jdc-cunningham/esp01-hydration-sensor/arduino/README.md

### About
The seeeduino interfaces with the moisture sensor and then uses the ESP-01 for WiFi communication to a local web server through HTTP.
