jdc-cunningham/esp01-hydration-sensor/arduino/esp_01/README.md

### About
This approach "failed".

Specifically I could not step the voltage down from the 3V max output of the analog sensor output for the ESP to consume it through the 1V max ADC.

This is one of the configurations I tried(other didn't have the MOSFET)

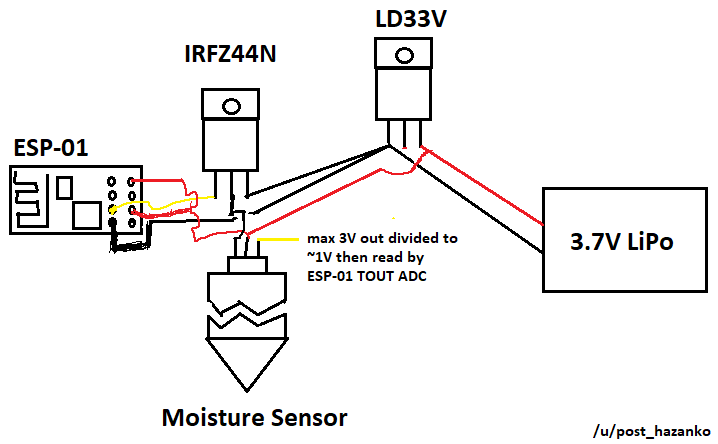
[picture p1: arduino/esp_01/wiring-diagram.png]
with mosfet


The on/off aspec works great, but as mentioned anytime I tried to drop the voltage down it would make the sensor not work.

Normally the sensor outputs between 2.2-2.6V in air and drops to 1.2V or so "fully submerged" in a cup of water.

That stops happening once I try to mod the output voltage.

I don't have any other components/parts at the moment to drop that voltage down and have spent far too much time on this version.

I just want "a moisture sensor" and I have these other ESP's to work with now.

I want to finish this project and move on.

The other version without MOSFET

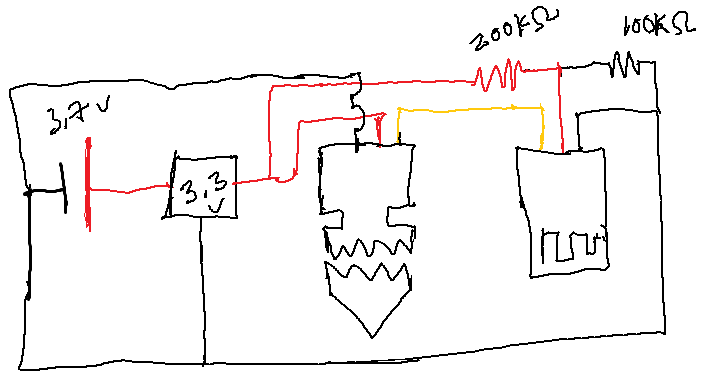
[picture p2: arduino/esp_01/circuit-diagram.png]
no MOSFET


Here it is wired up, I pulled off the yellow/black wires for probing, trying to get the analog value stepped down. The 330 ohm total resistance was too low also, had to use Mega Ohms to get near 1V vs. 0.008V

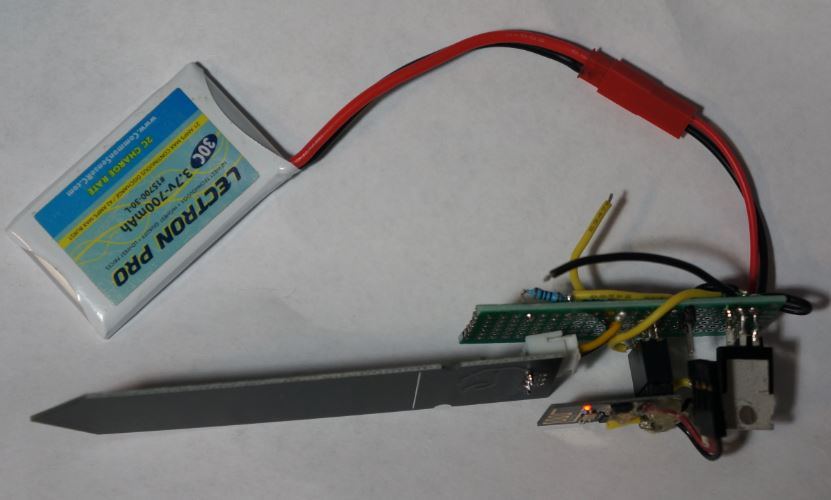
[picture p3: arduino/esp_01/esp-01-last-state.JPG]
last wired up state
