jdc-cunningham/esp01-hydration-sensor/3d-files/test-print.stl

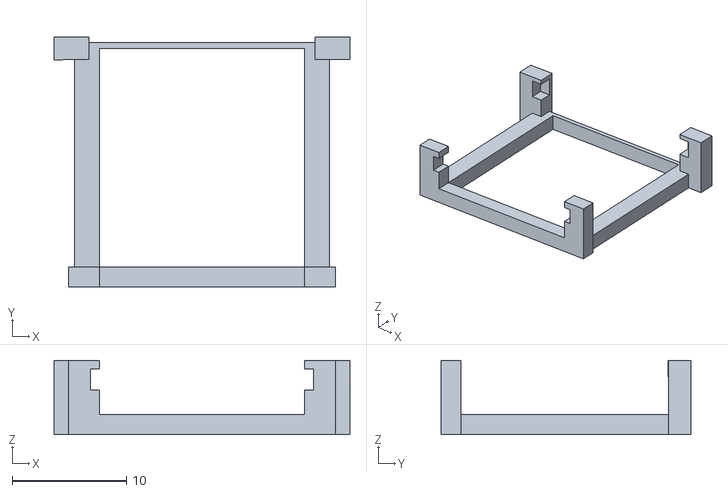
[picture p4: CAD file, 2021-02-21]
3d-files/test-print.stl
25.9 x 21.9 x 6.49
