jdc-cunningham/esp01-hydration-sensor/(list of files, cad)

Other CAD files:
3d-files/1cell-lipo.skp
3d-files/ESP-01.skp
3d-files/LD33V Linear Regulator.skp
3d-files/LD33V Voltage Regulator.skp
3d-files/assembly.skp
3d-files/capacitive-moisture-sensor.skp
3d-files/main-assembly.skp
3d-files/test-print.skp
3d-files/volume-modeling/2S_1100mAh.skp
3d-files/volume-modeling/2S_BMS.skp
3d-files/volume-modeling/step_down_buck_converter.skp
