jdc-cunningham/esp01-hydration-sensor/arduino/seeeduino/seeeduino.ino

void setup() {
  // Serial.begin(115200); // to monitor // also sends
  Serial1.begin(115200); // to ESP // also works
  analogReadResolution(10);
  pinMode(0, OUTPUT);
}

void loop() {
  Serial1.write(9999); // seeeduino booted avoiding long strings
  delay(2000); // still using unguaranteed delays
  digitalWrite(0, HIGH);
  delay(5000);
  int aVal = analogRead(A1);
  digitalWrite(0, LOW);
  // Serial.println("done measuring"); // comment out if monitor not connected
  Serial1.write(aVal);
  delay(10000); // this shouldn't turn on again for a while
}
