jdc-cunningham/esp01-hydration-sensor/(commit log)

2021-02-21 current 3d files, still in progress designing assembly then covers
    [1cell-lipo.skp, ESP-01.skp, LD33V Linear Regulator.skp, LD33V Voltage Regulator.skp, assembly.skp, capacitive-moisture-sensor.skp, main-assembly.skp, test-print.skp]
2021-02-21 current files sensor died have to wait to get new ones
2021-02-24 changes for MOSFET
2021-03-05 came up with new approach so I can use all pins no relay
2021-03-14 add nodes about BMS
2021-03-21 you are failing doctor
    seeeduino getting stuck in a bad state, serial string matching not working 9999 was desperation
    [esp_01.ino, seeeduino.ino]
